propella/netPeek/diagram.png

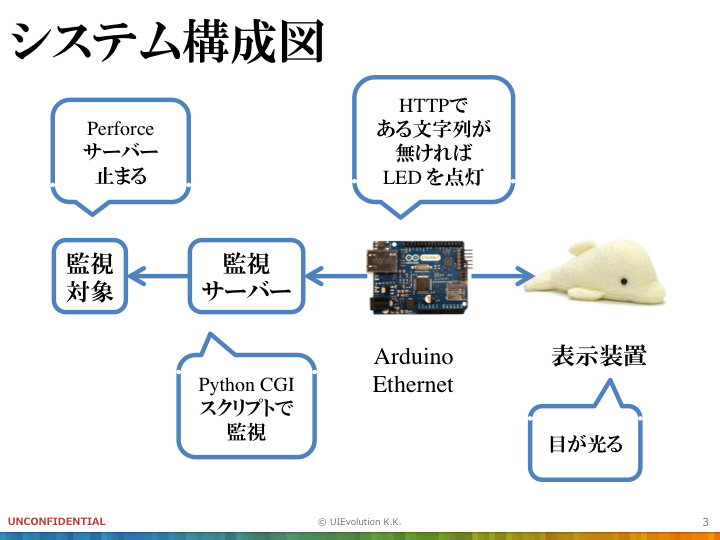
diagram.png
