propella/netPeek/NetPeek.png

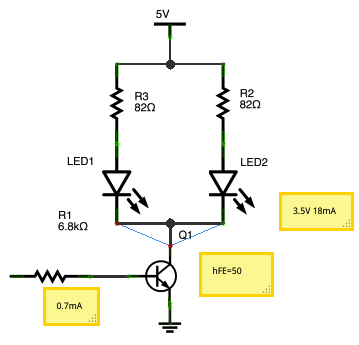
NetPeek.png
