propella/netPeek/NetPeek_bb.png

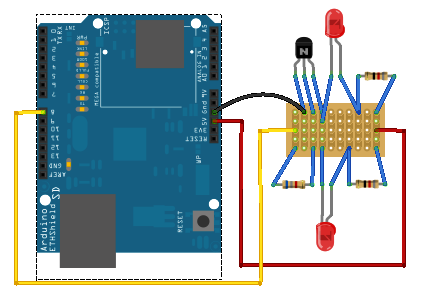
NetPeek_bb.png
