propella/netPeek/(list of files, drawings)

Other design files:
NetPeek.fzz
